h-gokul/Human-Robot-Interactive-Systems-for-a-3-DOF-Robotic-Arm/(commit log)

2019-06-01 Add files via upload
    The user needs to wear a sensor embedded glove to control a robotic arm. Contains the arduino code for the glove designed with IMU sensors placed in two locations which provide signal captured from the 3 dimensional motion of the user's arm. The data is translated to actuate the robotic arm's servo motors. This acts are a user interface and this is an initial step towards implementation of AI (imitative learning) in the 3DOF robotic arm.
2019-06-01 Add files via upload
    Contains the code for the actuation of 3 servo motors of the 3DOF robotic arm with the help of a sensor glove like user interface. Inertial Measurement units are used to capture the angular motion of the user's arm who is wearing the glove to control the robotic arm.
2019-08-28 Arduino Code
    For Real time operation of Sensor Based Glove
